msiecinski/Hexapod/hexapod_stl/hexapod_assembling.SLDASM

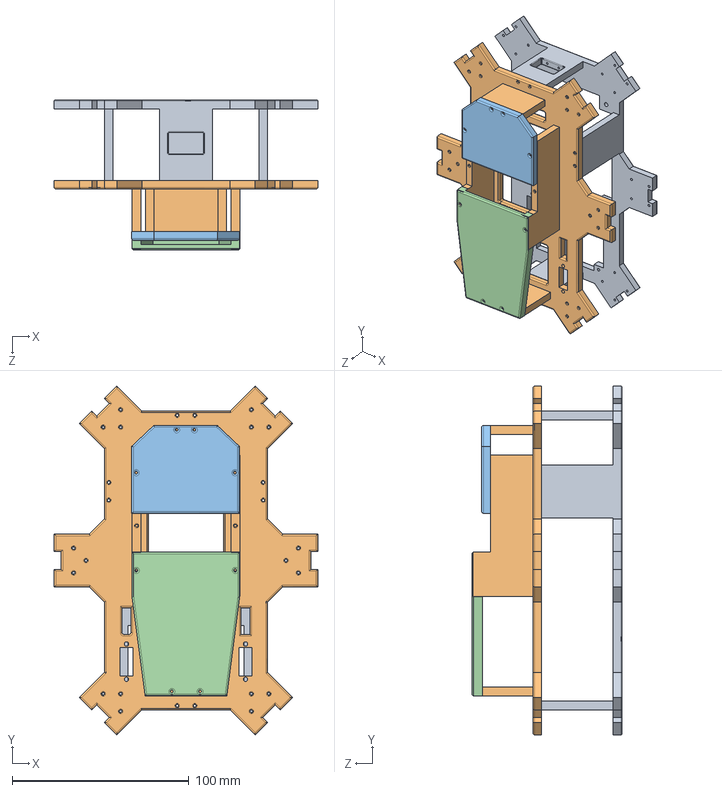
[picture p1: CAD file, 2021-03-30]
hexapod_stl/hexapod_assembling.SLDASM
149.4 x 197.7 x 85.0 mm
hexapod_bottom
hexapod_top
hexapod_hat_2
hexapod_hat_1
