msiecinski/Hexapod/hexapod_stl/hexapod_hat_1.SLDPRT

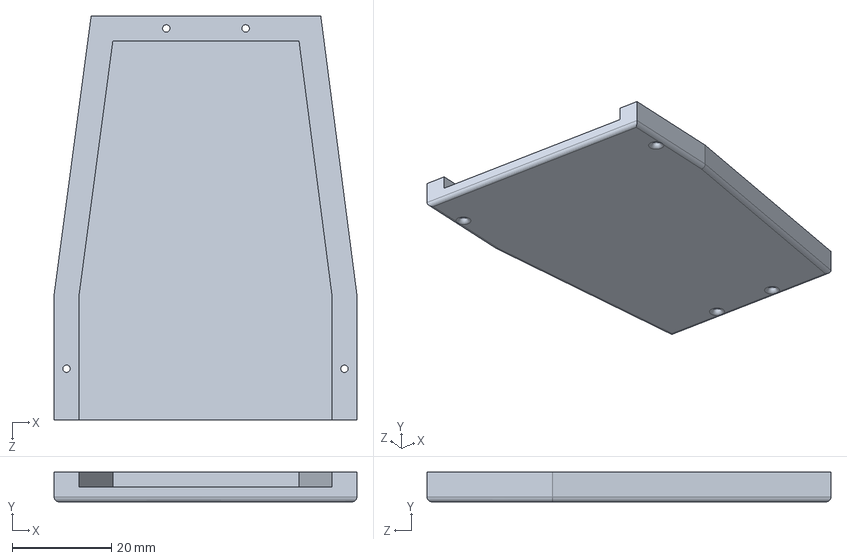
[picture p2: CAD file, 2021-03-30]
hexapod_stl/hexapod_hat_1.SLDPRT
61.0 x 6.00 x 81.4 mm
