msiecinski/Hexapod/hexapod_stl/hexapod_hat_2.SLDPRT

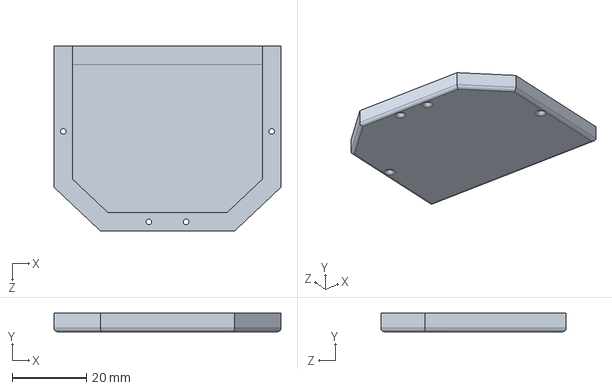
[picture p3: CAD file, 2021-03-30]
hexapod_stl/hexapod_hat_2.SLDPRT
61.0 x 5.00 x 49.8 mm
