msiecinski/Hexapod/hexapod_stl/hexapod_top.SLDPRT

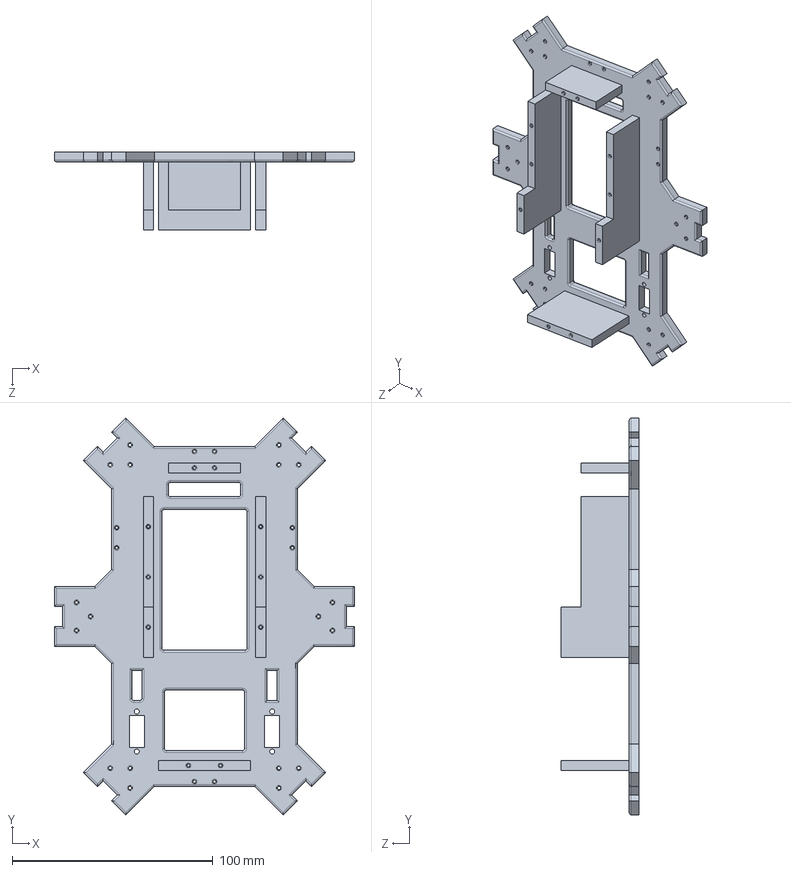
[picture p4: CAD file, 2021-03-24]
hexapod_stl/hexapod_top.SLDPRT
149.4 x 197.7 x 39.0 mm
