msiecinski/Hexapod/hexapod_stl/hexapod_bottom.SLDPRT

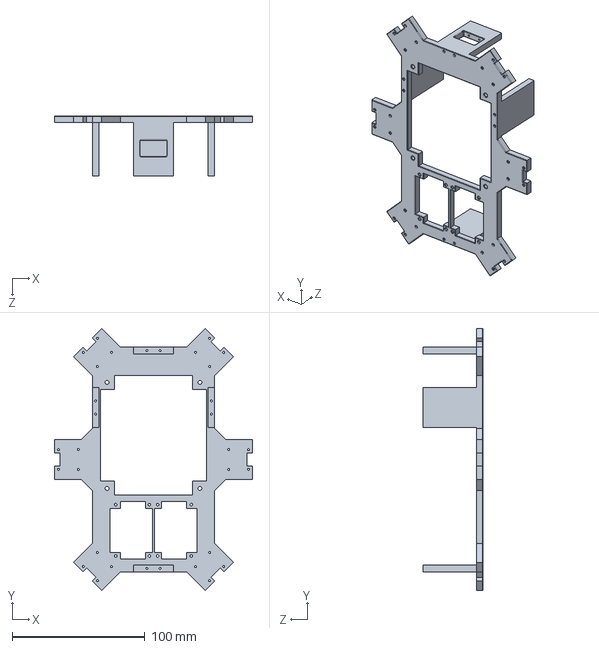
[picture p5: CAD file, 2021-03-24]
hexapod_stl/hexapod_bottom.SLDPRT
149.4 x 197.7 x 45.5 mm
