msiecinski/Hexapod/hexapod_stl/leg_part_2.SLDPRT

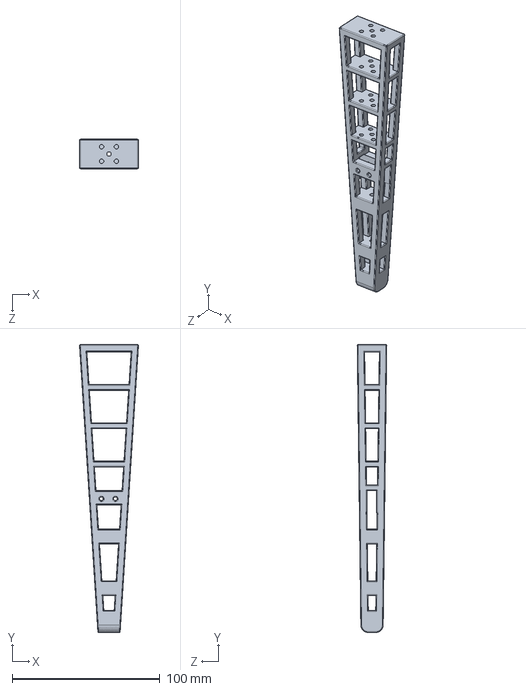
[picture p6: CAD file, 2020-11-11]
hexapod_stl/leg_part_2.SLDPRT
39.9 x 195.0 x 20.0 mm
