msiecinski/Hexapod/hexapod_stl/leg_part_1.SLDPRT

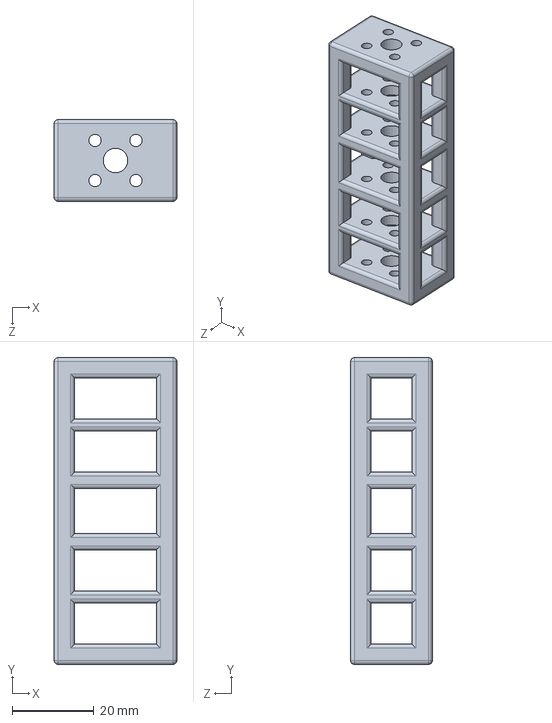
[picture p7: CAD file, 2020-10-21]
hexapod_stl/leg_part_1.SLDPRT
30.0 x 75.0 x 20.0 mm
