msiecinski/Hexapod/(list of files, cad)

Other CAD files:
hexapod_stl/hexapod_assembling.STL
hexapod_stl/hexapod_bottom.STL
hexapod_stl/hexapod_hat_1.STL
hexapod_stl/hexapod_hat_2.STL
hexapod_stl/hexapod_top.STL
hexapod_stl/leg_part_1.STL
hexapod_stl/leg_part_2.STL
