msiecinski/Hexapod/(threads)

Thread 1 (2020-10-15):

PCB board v2

msiecinski, 2020-10-15:
-on/off swich for power mcu(was in last update)
-add 2 leds for comunication
-new package for voltage regulator
-supply for ground sensor
-fix voltage sensor
-second battery voltage sensor
Not yet
-add 2 new serwos
-add sensor problably ultrasonic or sharp

Closed 2020-10-15.

Thread 4 (2020-10-15):

Body STL project v2

msiecinski, 2020-10-15:
Updated allready existed body:
-add battery place
-hole for programmer cable
-hole for usb dongle

Closed 2021-03-24.

Thread 6 (2020-10-15):

PCB board v2

msiecinski, 2020-10-15:
-on/off swich for power mcu(was in last update)
-add 2 leds for comunication
-new package for voltage regulator
-supply for ground sensor
-fix voltage sensor
-second battery voltage sensor
Not yet
-add 2 new serwos
-add sensor probably ultrasonic or sharp

msiecinski, 2020-10-15:
Already done:
-on/off swich for power mcu(was in last update)
-add 2 leds for comunication
-new package for voltage regulator
-supply for ground sensor
-fix voltage sensor
-second battery voltage sensor
