msiecinski/Hexapod/hexapod_eagle/hexa_board.brd

## EAGLE design hexapod_eagle/hexa_board.brd (2021-03-22)

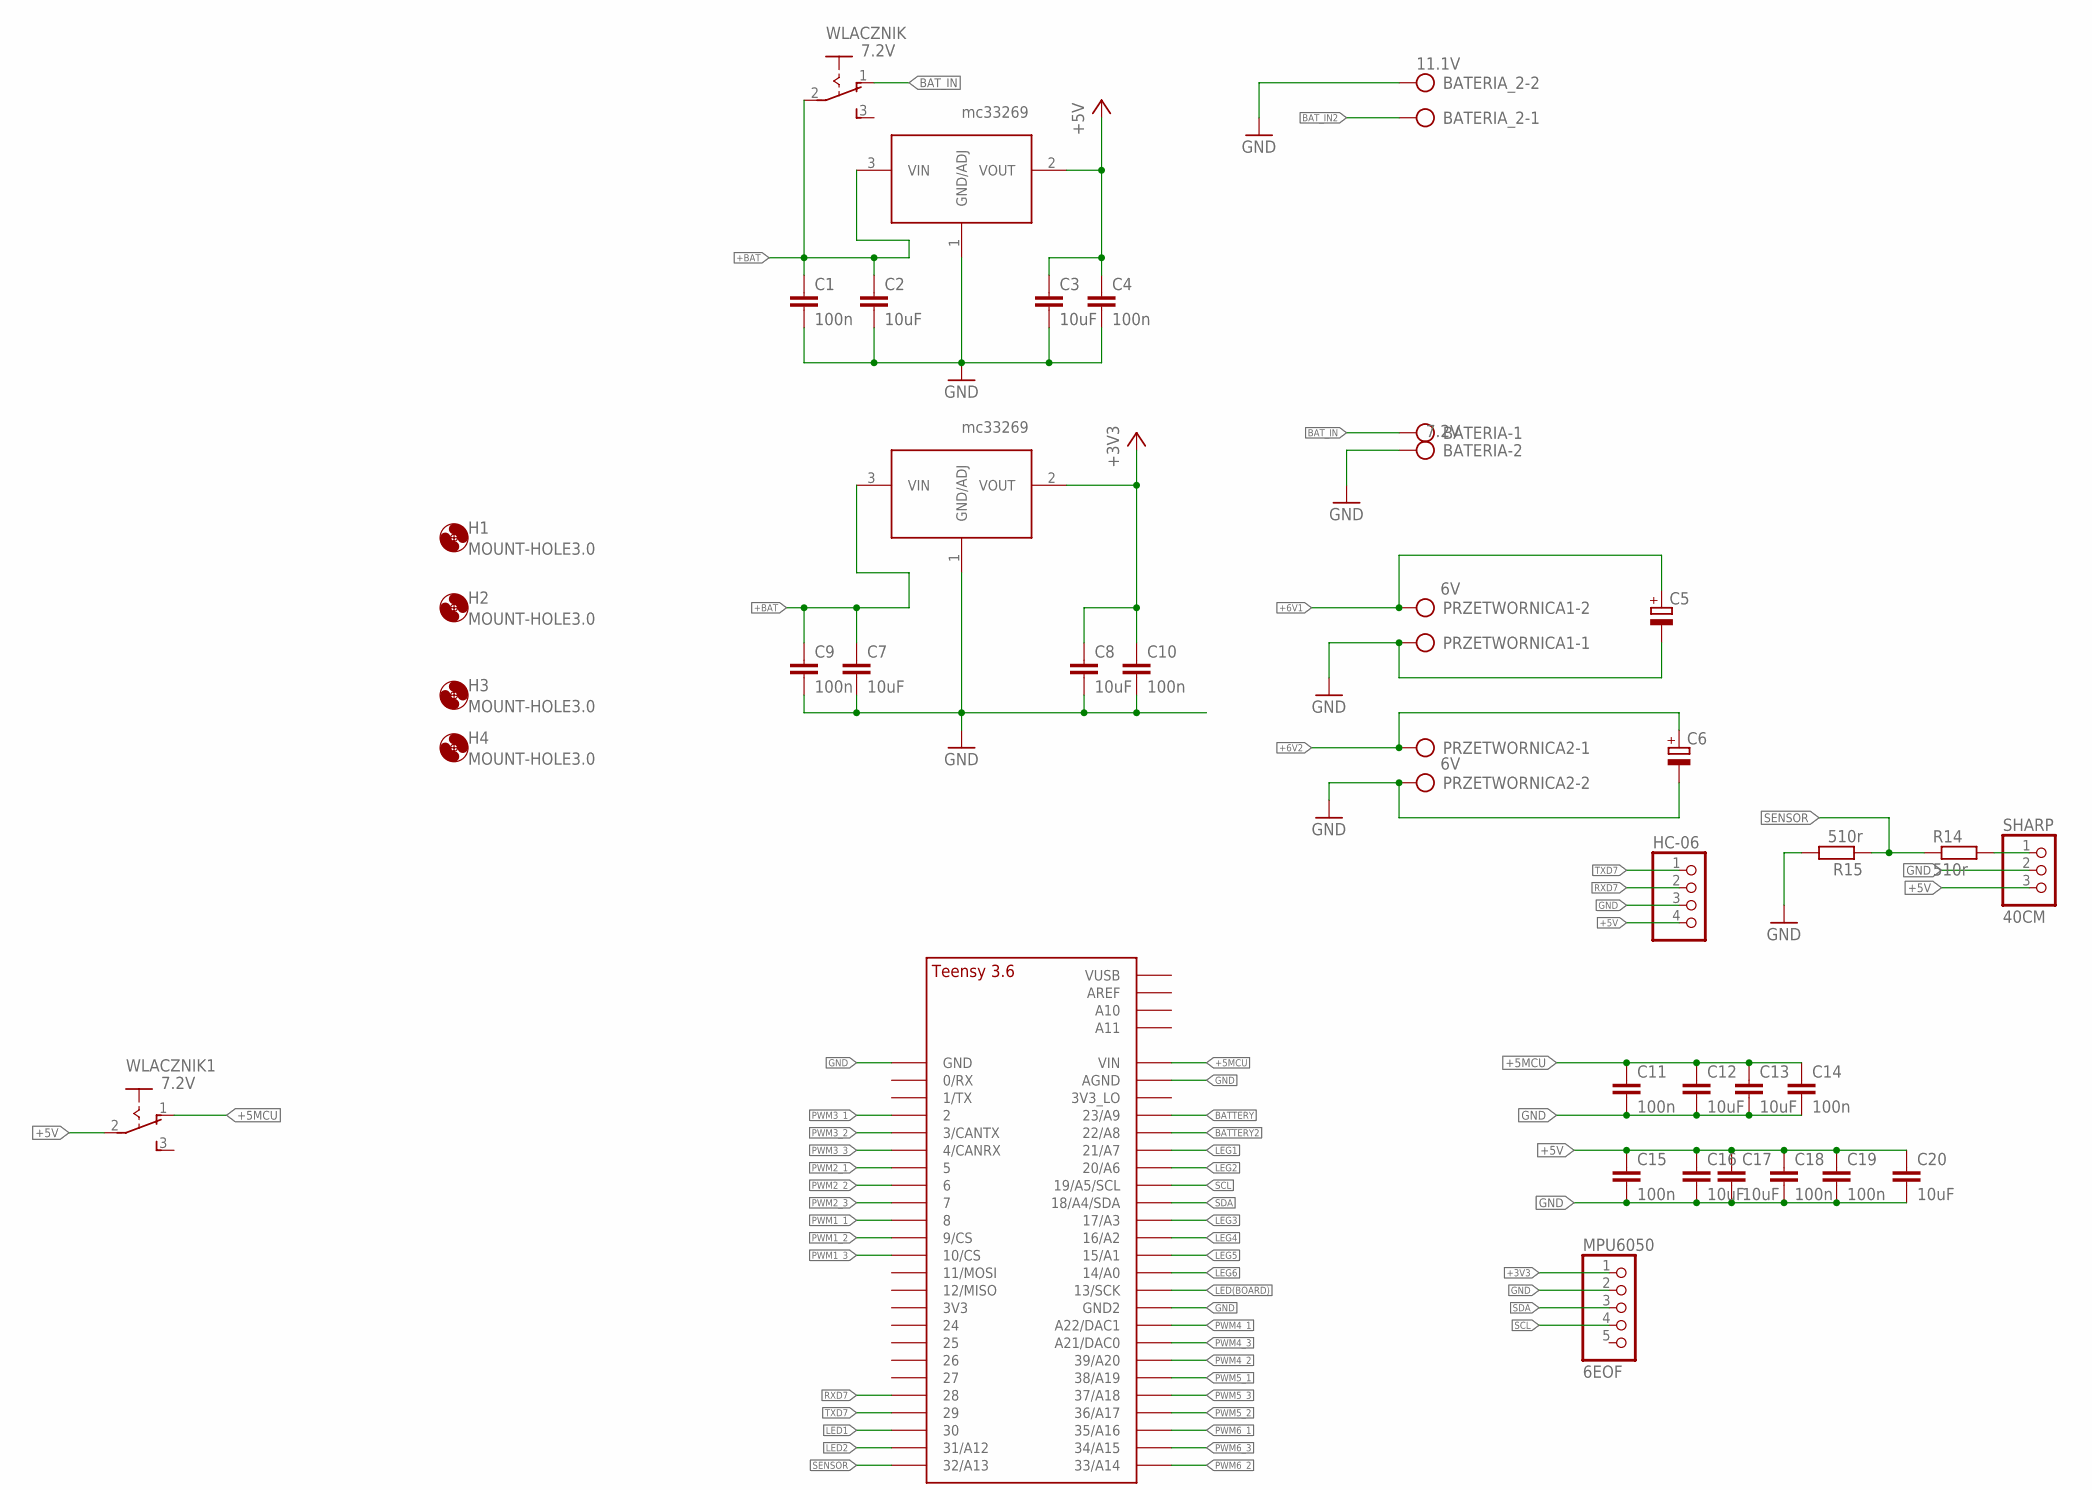
[picture p8: schematic hexa_board.sch, part in row 1, column 1]

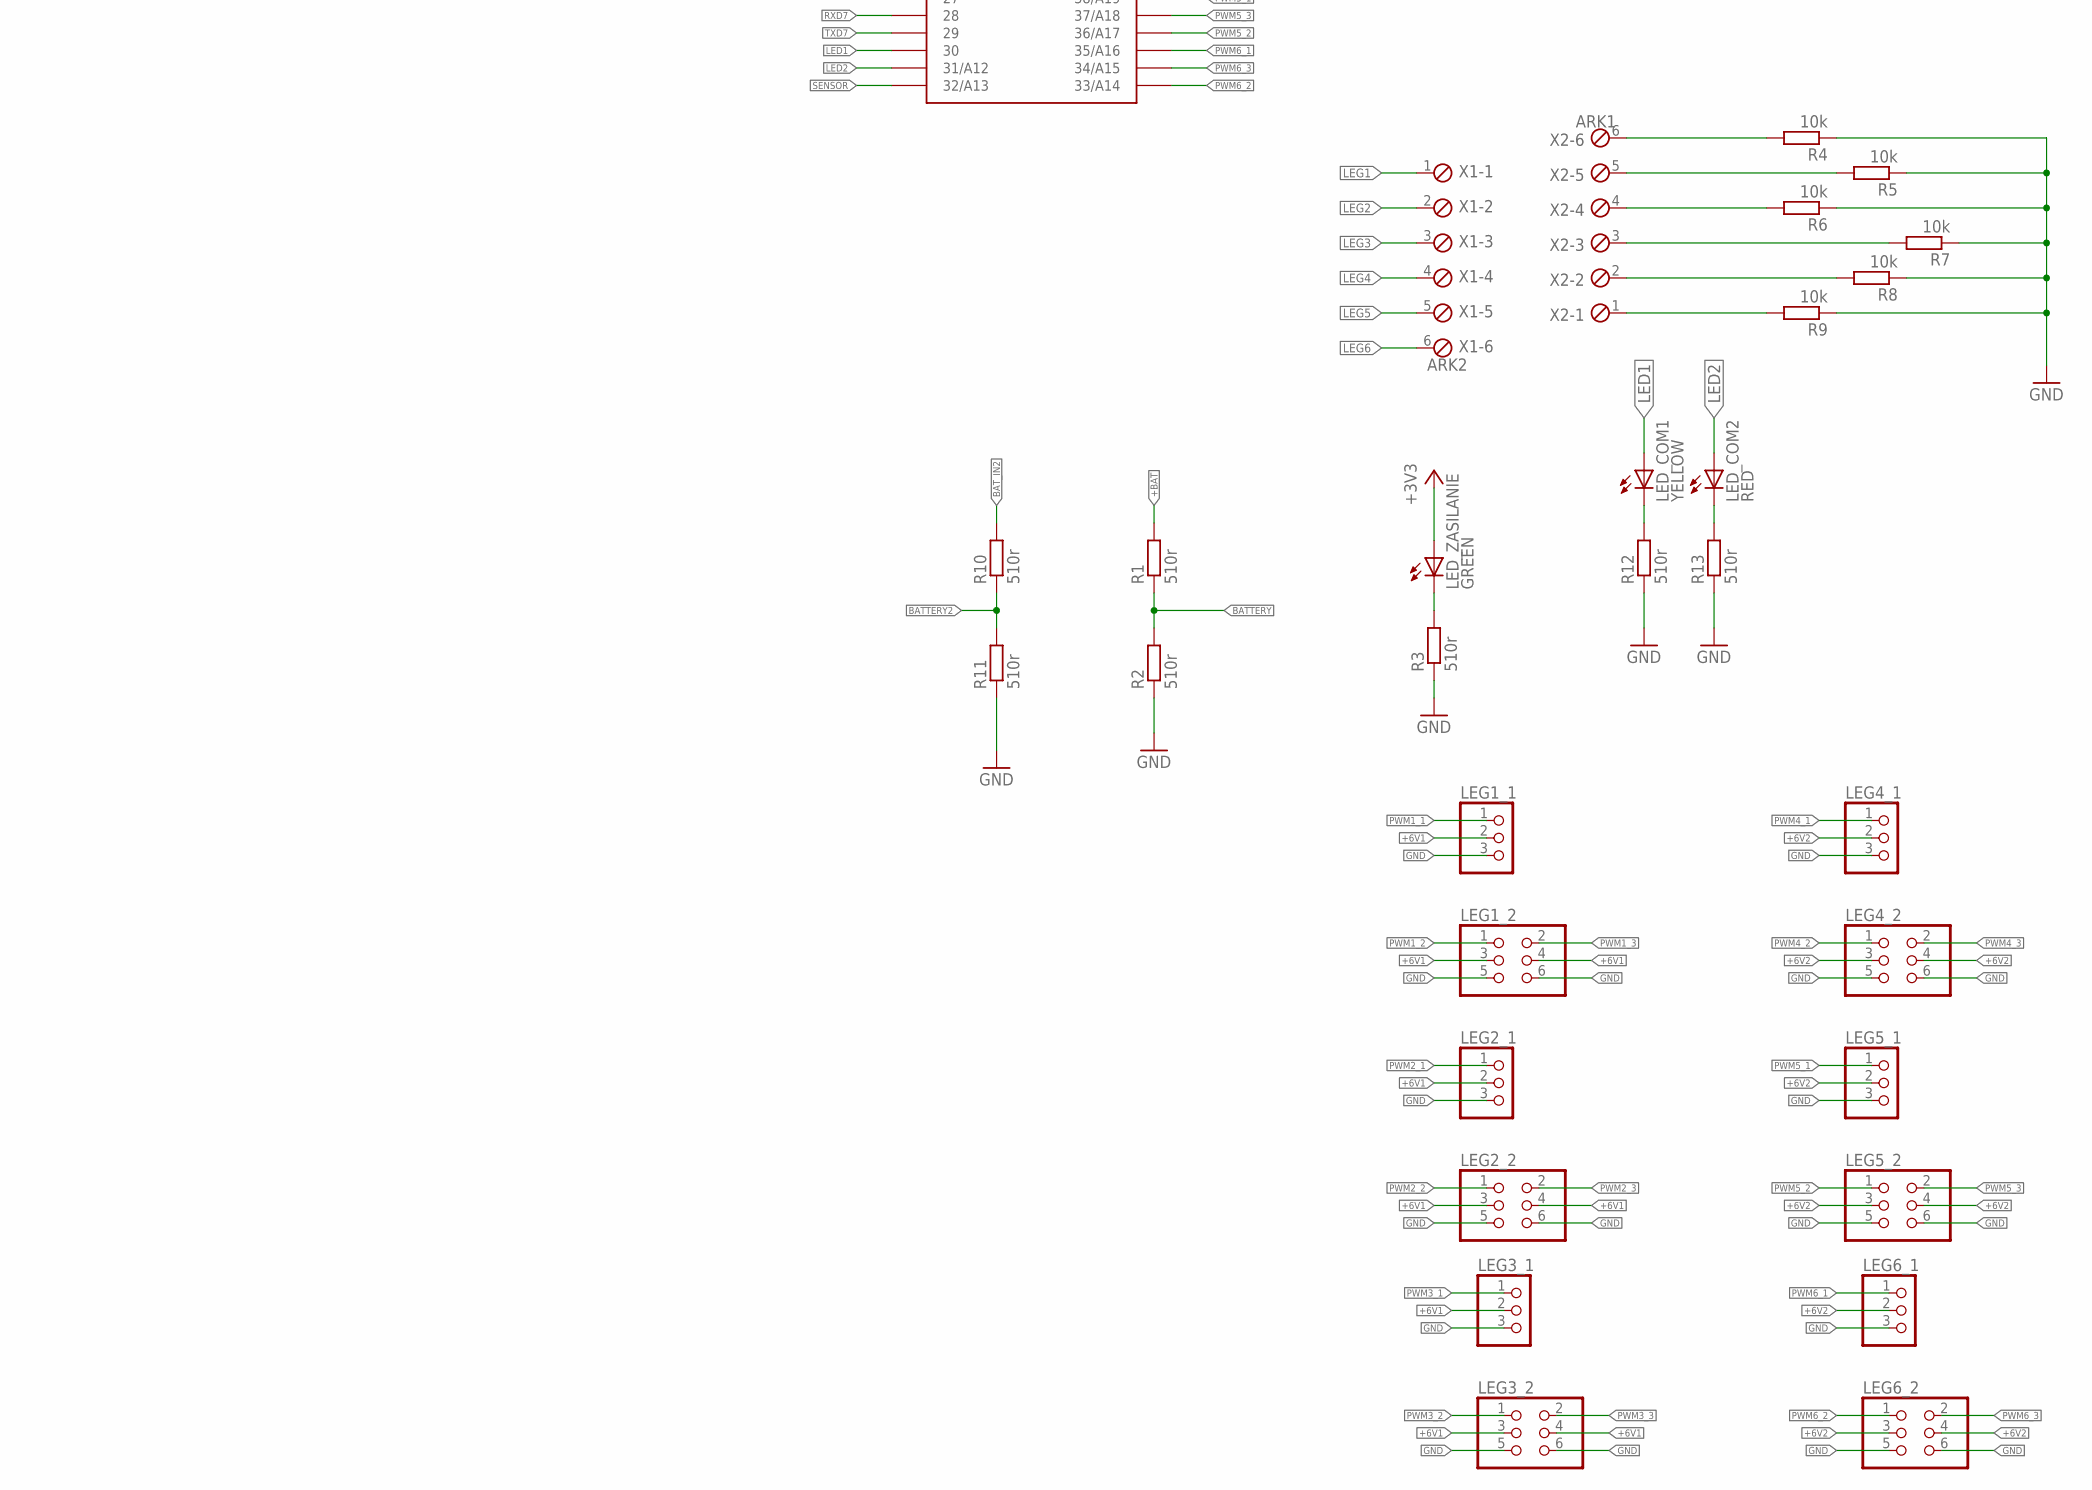
[picture p9: schematic hexa_board.sch, part in row 2, column 1]

Parts:
3V, 5V: MC33269; TO220
BATERIA: 7.2V; AK300/2
BATERIA_2: 11.1V; AK300/2
C1, C4, C9, C10, C11, C14, C15, C18, C19: 100n; C0805
C2, C3, C7, C8, C12, C13, C16, C17, C20: 10uF; C1206
C5, C6: CPOL-EU150CLZ-1014; 150CLZ-1014
H1, H2, H3, H4: MOUNT-HOLE3.0; 3,0
HC-06: PINHD-1X4; 1X04
LED_COM1: YELLOW; SML0805
LED_COM2: RED; SML0805
LED_ZASILANIE: GREEN; SML0805
LEG1_1, LEG2_1, LEG3_1, LEG4_1, LEG5_1, LEG6_1: PINHD-1X3; 1X03
LEG1_2, LEG2_2, LEG3_2, LEG4_2, LEG5_2, LEG6_2: PINHD-2X3; 2X03
MPU6050: 6EOF; 1X05
PRZETWORNICA1, PRZETWORNICA2: 6V; AK300/2
R1, R2, R3, R10, R11, R12, R13, R14, R15: 510r; R0805
R4, R5, R6, R7, R8, R9: 10k; R0805
SHARP: 40CM; 1X03
TEENSY41: TEENSY_3.5/3.6_BASIC
WLACZNIK, WLACZNIK1: 7.2V; 255SB
X1: ARK2; 6POL254
X2: ARK1; 6POL254

Connections:
+3V3: 3V.2 (VOUT), C8.1, C10.1, LED_ZASILANIE.A, MPU6050.1
+5MCU: C11.1, C12.1, C13.1, C14.1, TEENSY41.VIN, WLACZNIK1.1 (O)
+5V: 5V.2 (VOUT), C3.1, C4.1, C15.1, C16.1, C17.1, C18.1, C19.1, C20.1, HC-06.4, SHARP.3, WLACZNIK1.2
+6V1: C5.+, LEG1_1.2, LEG1_2.3, LEG1_2.4, LEG2_1.2, LEG2_2.3, LEG2_2.4, LEG3_1.2, LEG3_2.3, LEG3_2.4, PRZETWORNICA1.2
+6V2: C6.+, LEG4_1.2, LEG4_2.3, LEG4_2.4, LEG5_1.2, LEG5_2.3, LEG5_2.4, LEG6_1.2, LEG6_2.3, LEG6_2.4, PRZETWORNICA2.1
+BAT: 3V.3 (VIN), 5V.3 (VIN), C1.1, C2.1, C7.1, C9.1, R1.2, WLACZNIK.2
BATTERY: R1.1, R2.2, TEENSY41.23/A9
BATTERY2: R10.1, R11.2, TEENSY41.22/A8
BAT_IN: BATERIA.1, WLACZNIK.1 (O)
BAT_IN2: BATERIA_2.1, R10.2
GND: 3V.1 (GND/ADJ), 5V.1 (GND/ADJ), BATERIA.2, BATERIA_2.2, C1.2, C2.2, C3.2, C4.2, C5.-, C6.-, C7.2, C8.2, C9.2, C10.2, C11.2, C12.2, C13.2, C14.2, C15.2, C16.2, C17.2, C18.2, C19.2, C20.2, HC-06.3, LEG1_1.3, LEG1_2.5, LEG1_2.6, LEG2_1.3, LEG2_2.5, LEG2_2.6, LEG3_1.3, LEG3_2.5, LEG3_2.6, LEG4_1.3, LEG4_2.5, LEG4_2.6, LEG5_1.3, LEG5_2.5, LEG5_2.6, LEG6_1.3, LEG6_2.5, LEG6_2.6, MPU6050.2, PRZETWORNICA1.1, PRZETWORNICA2.2, R2.1, R3.1, R4.1, R5.1, R6.1, R7.1, R8.1, R9.1, R11.1, R12.1, R13.1, R15.2, SHARP.2, TEENSY41.AGND, TEENSY41.GND, TEENSY41.GND2
LED1: LED_COM1.A, TEENSY41.30
LED2: LED_COM2.A, TEENSY41.31/A12
LED(BOARD): TEENSY41.13/SCK
LEG1: TEENSY41.21/A7, X1.1
LEG2: TEENSY41.20/A6, X1.2
LEG3: TEENSY41.17/A3, X1.3
LEG4: TEENSY41.16/A2, X1.4
LEG5: TEENSY41.15/A1, X1.5
LEG6: TEENSY41.14/A0, X1.6
unnamed: R4.2, X2.6
unnamed: R5.2, X2.5
unnamed: R6.2, X2.4
unnamed: LED_ZASILANIE.C, R3.2
unnamed: R7.2, X2.3
unnamed: R8.2, X2.2
unnamed: R9.2, X2.1
unnamed: LED_COM1.C, R12.2
unnamed: LED_COM2.C, R13.2
unnamed: R14.2, SHARP.1
PWM1_1: LEG1_1.1, TEENSY41.8
PWM1_2: LEG1_2.1, TEENSY41.9/CS
PWM1_3: LEG1_2.2, TEENSY41.10/CS
PWM2_1: LEG2_1.1, TEENSY41.5
PWM2_2: LEG2_2.1, TEENSY41.6
PWM2_3: LEG2_2.2, TEENSY41.7
PWM3_1: LEG3_1.1, TEENSY41.2
PWM3_2: LEG3_2.1, TEENSY41.3/CANTX
PWM3_3: LEG3_2.2, TEENSY41.4/CANRX
PWM4_1: LEG4_1.1, TEENSY41.A22/DAC1
PWM4_2: LEG4_2.1, TEENSY41.39/A20
PWM4_3: LEG4_2.2, TEENSY41.21/DAC0 (A21/DAC0)
PWM5_1: LEG5_1.1, TEENSY41.38/A19
PWM5_2: LEG5_2.1, TEENSY41.36/A17
PWM5_3: LEG5_2.2, TEENSY41.37/A18
PWM6_1: LEG6_1.1, TEENSY41.35/A16
PWM6_2: LEG6_2.1, TEENSY41.33/A14
PWM6_3: LEG6_2.2, TEENSY41.34/A15
RXD7: HC-06.2, TEENSY41.28
SCL: MPU6050.4, TEENSY41.19/A5/SCL
SDA: MPU6050.3, TEENSY41.18/A4/SDA
SENSOR: R14.1, R15.1, TEENSY41.32/A13
TXD7: HC-06.1, TEENSY41.29

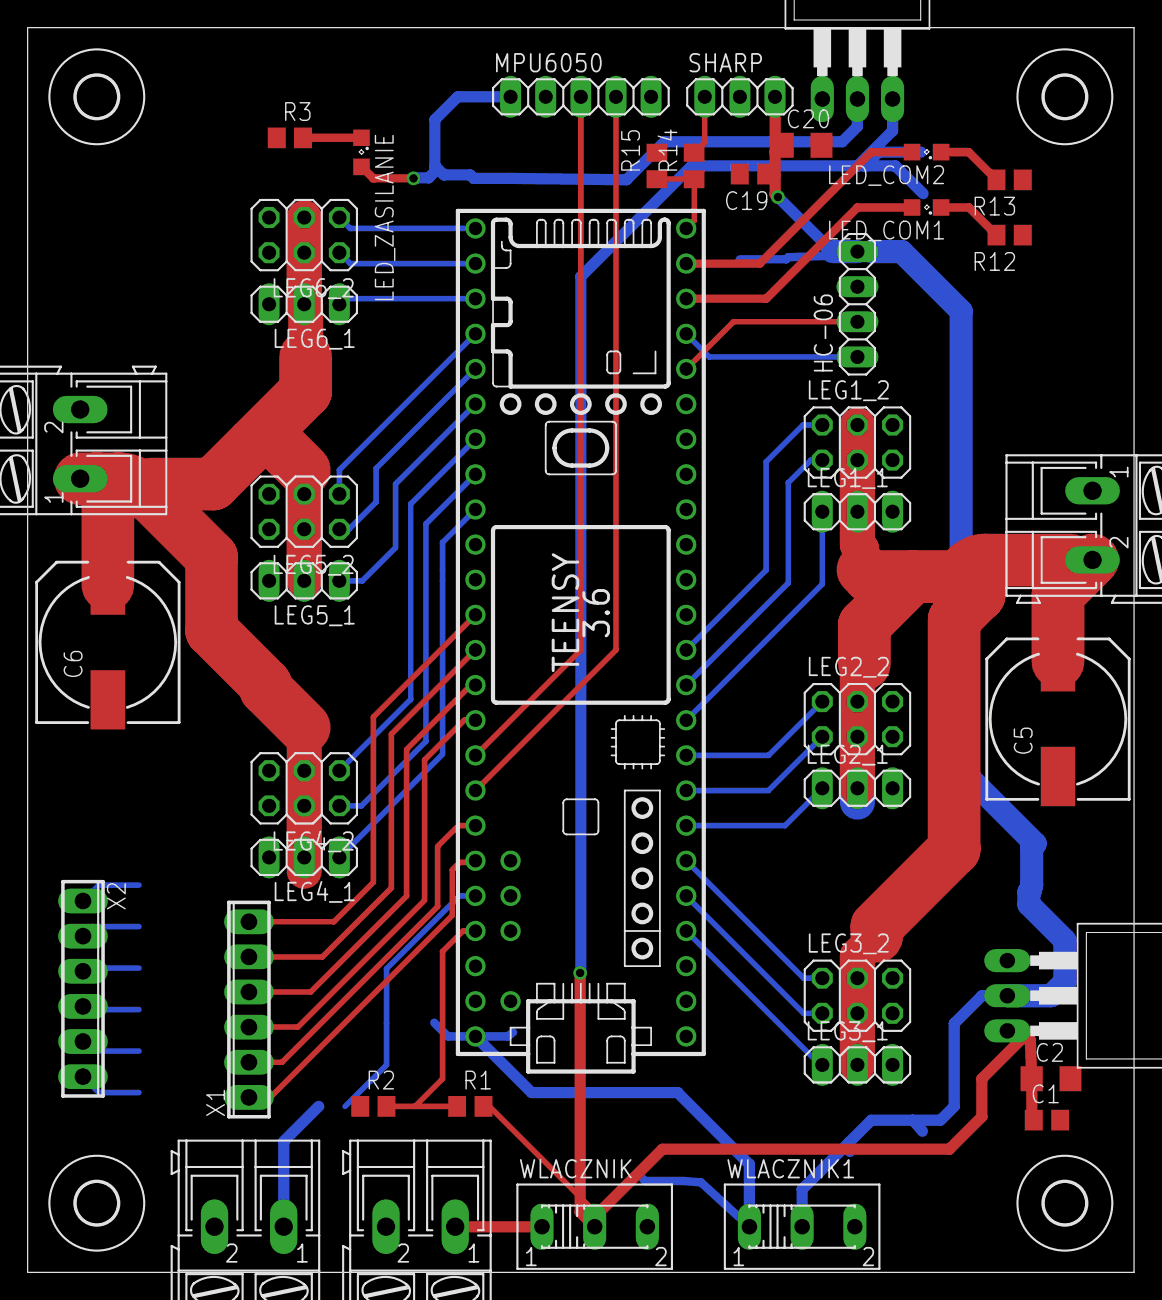
[picture p10: board hexa_board.brd from above]

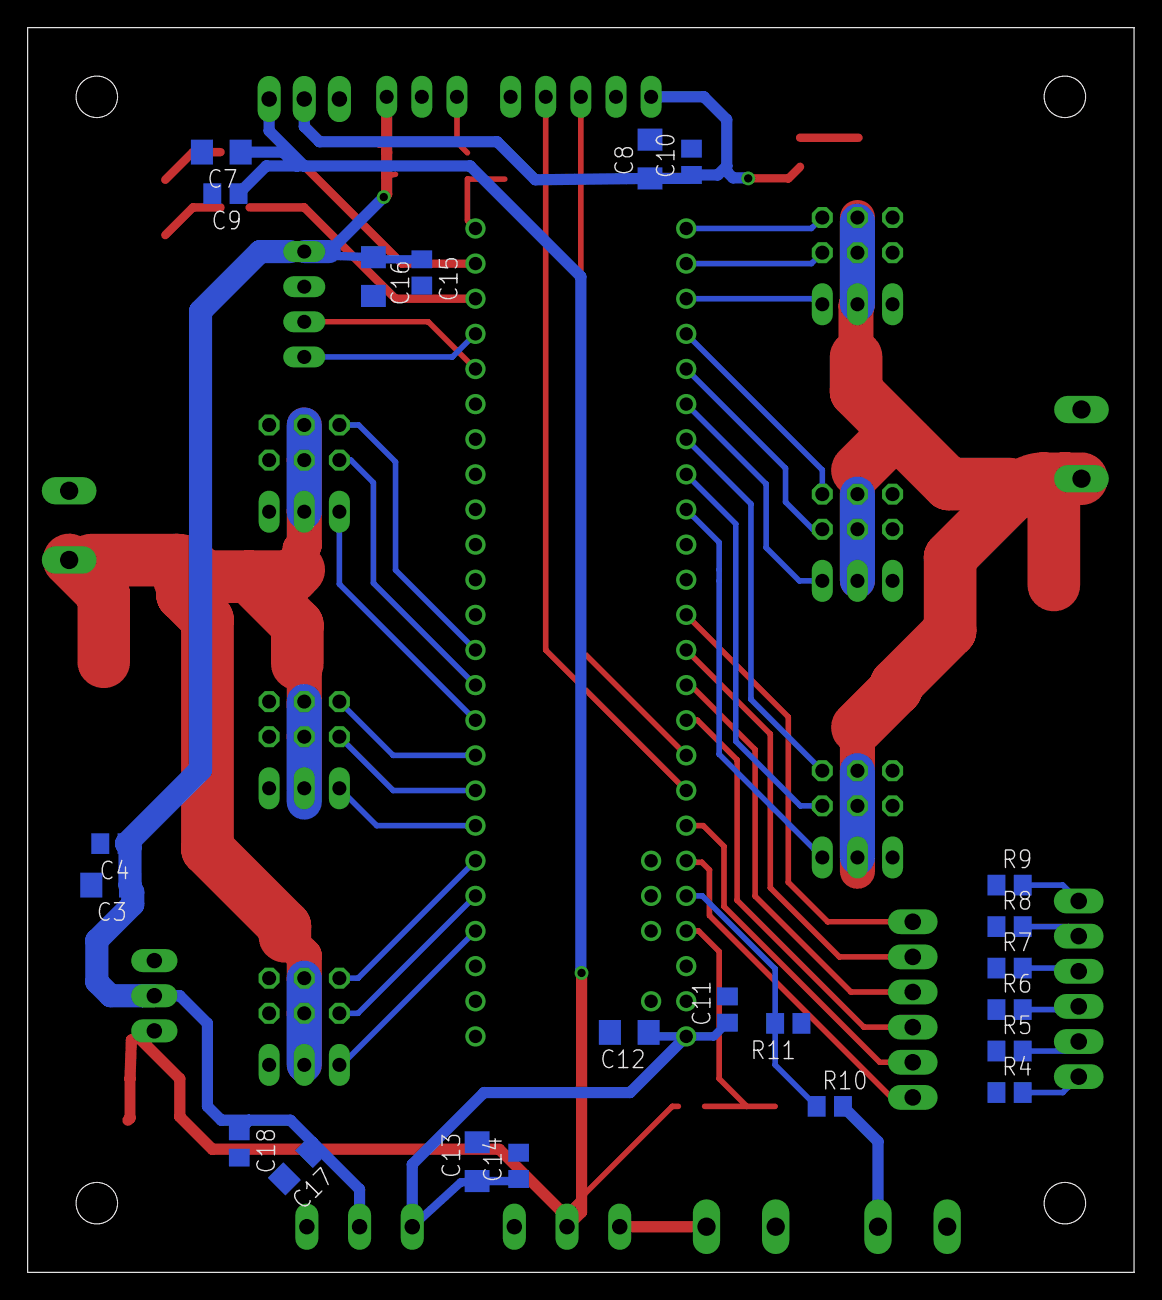
[picture p11: board hexa_board.brd from below]

Board: 2 copper layers, 80.0 x 90.0 mm, 68 parts (22 on the bottom side), 52 nets.
