msiecinski/Hexapod/hexapod_eagle/SharpBoard/sharpboard.brd

## EAGLE design hexapod_eagle/SharpBoard/sharpboard.brd (2020-10-28)

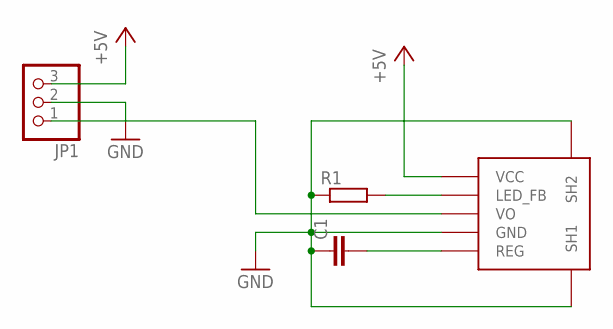
[picture p12: schematic sharpboard.sch]

Parts:
C1: C-EUC0805; C0805
JP1: PINHD-1X3; 1X03
R1: R-EU_R0805; R0805
U$2: GP2Y0D340K0F

Connections:
+5V: JP1.3, U$2.P$1 (VCC)
GND: C1.1, JP1.2, R1.1, U$2.P$4 (GND), U$2.P$6 (SH1), U$2.P$7 (SH2)
unnamed: R1.2, U$2.P$2 (LED_FB)
unnamed: C1.2, U$2.P$5 (REG)
unnamed: JP1.1, U$2.P$3 (VO)

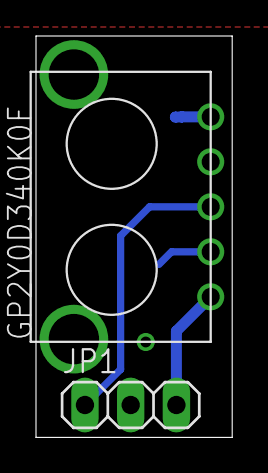
[picture p13: board sharpboard.brd from above]

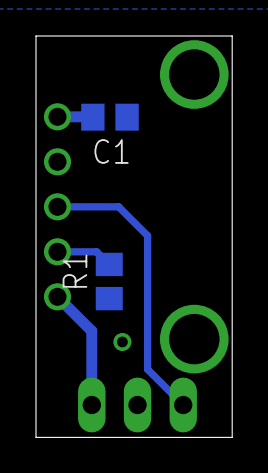
[picture p14: board sharpboard.brd from below]

Board: 2 copper layers, 10.9 x 22.3 mm, 4 parts (2 on the bottom side), 5 nets.
