msiecinski/Hexapod/hexapod_source_code/include/Leg.hpp

#ifndef Leg_H_
#define Leg_H_

#define LEG1_1 (8)
#define LEG1_2 (9)
#define LEG1_3 (10)

#define LEG2_1  (5)
#define LEG2_2  (6)
#define LEG2_3  (7)

#define LEG3_1 (2)
#define LEG3_2 (3)
#define LEG3_3 (4)

#define LEG4_1 (41)
#define LEG4_2 (40)
#define LEG4_3 (39)

#define LEG5_1 (38)
#define LEG5_2 (37)
#define LEG5_3 (36)

#define LEG6_1 (35)
#define LEG6_2 (34)
#define LEG6_3 (33)

#define SENSOR_1 (21)
#define SENSOR_2 (20)
#define SENSOR_3 (17)
#define SENSOR_4 (16)
#define SENSOR_5 (15)
#define SENSOR_6 (14)

#define ADC_SENSOR_1    (A9)
#define ADC_SENSOR_2    (A8)
#define ADC_LED_1       (30)
#define ADC_LED_2       (31)

#define SHARP_SENSOR    (32)

#endif /* Leg_H_ */
