msiecinski/Hexapod/hexapod_source_code/include/Kinematics.hpp

#ifndef Kinematics_H_
#define Kinematics_H_

#include <Global_defines.hpp>
 
  //Functions designed to implement motion
  void InversKinematics(hexapod &);          //
  void AngleToDuty(hexapod &);              //conver input angles to duty for pwm
  void RotateCordinate(const int, position &, const int, const int = 0);
  double CalculateHeight(double, double);
   
#endif /* Kinematics_H_ */
