msiecinski/Hexapod/hexapod_source_code/include/Timefunc.hpp

#ifndef Interrupts_H_
#define Interrupts_H_
    
    void PWM50Hz(void);              //genering PWM @18pins
    void DelayFunc(void);            //genering delays
    void ReadFunc(void);            //genering delays
       

#endif /* Interrupts_H_ */
