msiecinski/Hexapod/hexapod_source_code/include/Gyroscope.hpp

#ifndef Gyroscope_H_
#define Gyroscope_H_ 
 
 #include <MPU6050.h>

#define NUMBERSAMPLES 10

 //Functions for using gyroscope 
void GyroReadAngle(void);             //function read data form MPU6050

#endif /* Gyroscope_H_ */
