msiecinski/Hexapod/(commit log)

2020-10-04 Hexapod eagle files
    Hexapod main board eagle files v1
    [hexa_board.brd, hexa_board.sch]
2020-10-04 Solidwors project files
    Hexapod mechanics construction files in solidworks
    [hexapod_dol_ready.SLDPRT, hexapod_dol_ready.STL, hexapod_gora_ready.SLDPRT, hexapod_gora_ready.STL]
2020-10-04 Hexapod board v2
    Changelog:
    -new package for voltage regulator
    -supply for ground sensor
    -fix voltage sensor
    -second battery voltage sensor
    [hexa_board.brd, hexa_board.sch]
2020-10-04 Board v2
    -on/off swich for power mcu(was in last update)
    -add 2 leds for comunication
    -some positions changes
    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
    [hexa_board.brd, hexa_board.sch]
2020-10-13 Fixed SetPosition function
    Added copy delay flag
    [movement.cpp]
2020-10-13 SlideHorizontal function upadate
    Fix errors in SlideHorizontal function, now probably is working well.
    [movement.cpp]
2020-10-14 Update SetupLeg
    Added init for all 18 joints.
2020-10-17 Update pwm function
    Some changes in pwm genereting function.
2020-10-17 Startup fix
    Fix startup for set position all legs.
    [main.cpp]
2020-10-18 Clean DelayFunc function
    Clean DelayFunc function from blink led(was for interrupt test)
2020-10-18 Updated PWM function
    Change variable type
2020-10-19 Added stl file
    -added 3d object(leg a2)
    [leg_a2_V2.STL]
2020-10-19 Update kinematics.cpp
    Change "0" postion angle q3 and some cosmetics changes.
2020-10-21 Add sldprt file
    Added missing sldprt file with part of leg.
    [leg_a2_V2.SLDPRT]
2020-10-21 Update main.cpp
    Fix setup startup postion all legs after reset
    [main.cpp]
2020-10-23 Added leg A3 files
    First version parf of leg(A3)
    [LEG_A3.SLDPRT]
2020-10-23 Change name
    Change name part of the leg
    [leg_a2_ready.SLDPRT, leg_a2_ready.STL]
2020-10-28 Update board project
    -fix voltage regulator output
    -added tantalum capacitors (B size)instead cpol
    [hexa_board.brd, hexa_board.sch]
2020-10-28 Update eagle board
    -added sharp sensor
    -some minor changes
    [hexa_board.brd, hexa_board.sch]
2020-10-28 Sharrp sensor bard
    Added board for Sharp GP2Y0D340K sensor.
    [sharpboard.brd, sharpboard.sch]
2020-10-30 Update gyroscope.cpp
    Delete prints for debug and some minor changes.
2020-10-31 Uddate cad files
    Changes in hehapod "base":
    -added place for battery
    -added place for usb hub
    -added hole for usb cable(for programming teensy)
    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
    [hexapod_dol_ready.SLDPRT, hexapod_dol_ready.STL, hexapod_gora_ready.SLDPRT, hexapod_gora_ready.STL]
2020-10-31 Update hexa_board.brd
    Delete drill size error
    [hexa_board.brd]
2020-10-31 Update leg A3
    New wersion of leg part - A3
    [LEG_A3.SLDPRT]
2020-11-07 Update movement.cpp
    Fix SetPosiotion function
    [movement.cpp]
2020-11-08 Update leg3
    New version of leg3, added place for limit switch
    [LEG_A3.SLDPRT, LEG_A3.STL]
2020-11-09 Added new funtion in kinematics.cpp
    Added new function(RotateCordinat) for rotate cordinates(base on robot build)
2020-11-09 Fixes movenet functions problems
    -fix Move and SlideHorizontal problems
    -change some const value
    [Global_defines.hpp, movement.cpp]
2020-11-09 Update control funtion
    Change in controll funtion, switch from ps4control.cpp to movement.cpp file
2020-11-09 Update leg A3
    -some changes in part of leg(A3)
    [LEG_A3.SLDPRT, LEG_A3.STL]
2020-11-10 Update kinematics files
    Added support for second parameter(y) in funnction RotateCordinate.
2020-11-11 Update CheckGround function
    -added function using to init "ground sensor pins"
    -added digital read from sensor pins in function GroundCheck
2020-11-11 Update movement.cpp
    -ON function CheckGround
    -fixes bugs with using function CheckGround.
    [movement.cpp]
2020-11-11 Update LEG_A3.SLDPRT
    Probably final version of A3(leg part).
    [LEG_A3.SLDPRT]
2020-11-14 Update eagle files
    -change to ark leg sensor pins
    -change isolte value
    -esp32 cam-insted bluetooth/"wifi"
    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
    [hexa_board.brd, hexa_board.sch]
2020-11-22 Changes in cad files
    Build v2 for top part hexapod main board.
    [hexapod_gora_ready.SLDPRT, hexapod_gora_ready.STL]
2021-02-25 Update
    Update move and kinematics functions
2021-03-02 Update for UART
    Some changes for init UART(for hc-06 module)
2021-03-22 Update eagle schematic and board
    -added capacitors
    -added voltage divider
    -change package some capacitors
    -added on/off swich for power mcu
    [hexa_board.brd, hexa_board.sch]
2021-03-22 Update eagle files
    -change positions some capacitors
    -change TXD/RXD lines
    -minor changes
    [hexa_board.brd, hexa_board.sch]
2021-03-22 Update eagle files
    Change some capacitors package.
    [hexa_board.brd, hexa_board.sch]
2021-03-23 Update cad files naming
    Change names cad files
    [leg_part_1.SLDPRT, leg_part_1.STL, leg_part_2.SLDPRT, leg_part_2.STL]
2021-03-24 Update cad files
    Names update and some minor changes.
    [hexapod_gora_ready.SLDPRT, hexapod_gora_ready.STL, hexapod_top.SLDPRT, hexapod_top.STL]
2021-03-24 Update cad files
    New names and minor changes.
    [hexapod_bottom.SLDPRT, hexapod_bottom.STL, hexapod_dol_ready.SLDPRT]
2021-03-24 Update cad files
    Minor dimetions changes.
    [hexapod_top.SLDPRT, hexapod_top.STL]
2021-03-24 Added assembling files
    Hexapod assembling cad files.
    [hexapod_assembling.SLDASM, hexapod_assembling.STL]
2021-03-29 Added new parts
    -added 2 new parts
    -update assembly
    [hexapod_assembling.SLDASM, hexapod_hat_1.SLDPRT, hexapod_hat_1.STL, hexapod_hat_2.SLDPRT, hexapod_hat_2.STL]
2021-03-29 Update cad files
    Minor changes
    [hexapod_assembling.SLDASM, hexapod_hat_1.SLDPRT, hexapod_hat_1.STL]
2021-03-30 Update cad files
    -some minor changes in "hats"
    [hexapod_assembling.SLDASM, hexapod_hat_1.SLDPRT, hexapod_hat_1.STL, hexapod_hat_2.SLDPRT, hexapod_hat_2.STL]
2021-04-12 update kinematics files
    Added new function for calculate height offset to obtain set angle.
